OpenAirCgn/quadsense/README.md

# OpenAir Quadsense Module

This is an extension module for the OpenAir.cgn base board
to connect to Alphasense gas concentration sensors using
Alphasense ISB boards to provide amplifier circuitry.

Schematics
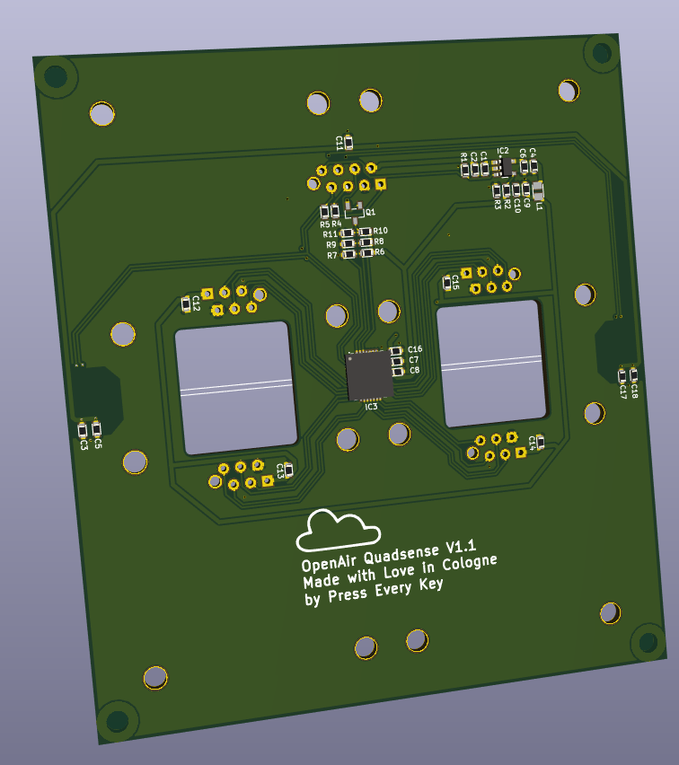
[picture p1: quadsense-classic.png]
Board
