OpenAirCgn/quadsense/Quadsense_BOM.ods

 |  |  |  |  |  |  |  |  |  |  |  | Units:
Non-listed components are unpopulated |  |  |  |  |  |  |  |  |  |  |  | 7
Qty | Reference(s) | Value | Footprint | Manufacturer | PN | Source | Source # | Source € | Source @ | Remarks | Cost/part | Needed | Avail | Remaining | Cost needed | Order | Cost order
 | Resistors
2 | R1, R10 | 10K | 0603 |  |  | avail |  |  |  |  | 0 | 14 | 999 | 0 | 0 |  | 0
1 | R2 | 9K1 | 0603 | Susumu | RR0816P-912-D | DK | RR08P9.1KDCT-ND | 0,086 | 10 |  | 0,086 | 7 | 7 | 0 | 0,602 | 10 | 0,86
1 | R3 | 2K2 | 0603 |  |  | avail |  |  |  |  | 0 | 7 | 999 | 0 | 0 |  | 0
5 | R6, R7, R8, R9, R11 | 0/DNP | 0603 |  |  | avail |  |  |  |  | 0 | 35 | 999 | 0 | 0 |  | 0
 |  |  |  |  |  |  |  |  |  |  |  |  |  |  |  |  | 0
 | Capacitors |  |  |  |  |  |  |  |  |  |  |  |  |  |  |  | 0
6 | C1, C2, C4, C6, C9, C11 | 1u | 0603 |  |  | avail |  |  |  |  | 0 | 42 | 999 | 0 | 0 |  | 0
9 | C3, C5, C7, C12, C13, C14, C15, C17, C18 | 0.1u | 0603 |  |  | avail |  |  |  |  | 0 | 63 | 999 | 0 | 0 |  | 0
2 | C8, C10 | 10u | 0603 | AVX | 0603ZD106KAT2A | DK | 478-10766-1-ND | 0,104 | 10 |  | 0,208 | 14 | 16 | 0 | 1,456 | 25 | 2,6 | incl noiseboard
1 | C16 | 1u/DNP
 |  |  |  |  |  |  |  |  |  |  |  |  |  |  |  |  | 0
 | Inductors |  |  |  |  |  |  |  |  |  |  |  |  |  |  |  | 0
1 | L1 | 22uH 1.27Ω | 0805 | TDK | MLZ2012P220WT000 | DK | 445-15751-1-ND | 0,115 | 10 |  | 0,115 | 7 |  | 7 | 0,805 | 10 | 1,15
1 | L1 | 47uH 3.7Ω | 0805 | TDK | MLZ2012M470WT000 | DK | 445-6400-1-ND | 0,115 | 10 |  | 0,115 | 7 |  | 7 | 0,805 | 10 | 1,15 | second option
 |  |  |  |  |  |  |  |  |  |  |  |  |  |  |  |  | 0
 | Discrete semiconductors |  |  |  |  |  |  |  |  |  |  |  |  |  |  |  | 0
1 | Q1 | AO3418 | SOT23-3 | A&O |  | DK | 785-1012-1-ND | 0,272 | 10 |  | 0,272 | 7 | 5 | 2 | 1,904 | 5 | 1,36
 |  |  |  |  |  |  |  |  |  |  |  |  |  |  |  |  | 0
 | ICs |  |  |  |  |  |  |  |  |  |  |  |  |  |  |  | 0
2 | IC1, IC4 | RH/T sens BME280 | BME280 | Bosch | BME280 | DK | 828-1063-1-ND | 6,86 | 1 |  | 13,72 | 14 | 4 | 10 | 96,04 | 10 | 68,6
1 | IC2 | LDO AP7330 | SOT23-5 | Diodes Inc | AP7330-W5-7 | DK | AP7330-W5-7DICT-ND | 0,315 | 10 |  | 0,315 | 7 | 3 | 4 | 2,205 | 4 | 1,26
1 | IC3 | ADC LTC2497 | QFN-38-12-7-0.5-EP | Linear Tech | LTC2497CUHF#PBF | DK | LTC2497CUHF#PBF-ND | 4,86 | 1 |  | 4,86 | 7 | 3 | 4 | 34,02 | 4 | 19,44
 |  |  |  |  |  |  |  |  |  |  |  |  |  |  |  |  | 0
 | Mechanical |  |  |  |  |  |  |  |  |  |  |  |  |  |  |  | 0
4 | P1, P2, P3, P4 | WTB direct conn 6 pin | HEADER-1x06-1.27-ZZ-POL | TE | 215570-6 | DK | A111110CT-ND | 0,54 | 10 |  | 2,16 | 28 | 20 | 8 | 15,12 | 10 | 5,4
1 | P5 | WTB direct conn 8 pin | HEADER-1x08-1.27-ZZ-POL | TE | 215570-8 | DK | A111111CT-ND | 0,56 | 10 |  | 0,56 | 7 | 10 | 0 | 3,92 | 15 | 8,4 | incl noiseboard
1 |  | WTB plug 8 pin |  | TE | 2178712-8 | DK | A120922CT-ND | 0,465 | 10 |  | 0,465 | 7 | 3 | 4 | 3,255 | 20 | 9,3 | incl noiseboard
4 |  | Sensor plug housing pol |  | Molex | 0022013067 | DK | WM2004-ND | 0,23 | 1 |  | 0,92 | 28 | 17 | 11 | 6,44 | 12 | 2,76
4 |  | Sensor plug housing |  | Molex | 0022012067 | DK | WM2015-ND | 0,23 | 1 |  | 0,92 | 28 |  | 28 | 6,44 |  | 0 | not needed
24 |  | Sensor plug contact |  | Molex | 0008500113 | DK | WM1114CT-ND | 0,037 | 100 |  | 0,888 | 168 | 100 | 68 | 6,216 | 200 | 7,4 | Incl Openair PM
16 |  | Spacer M3 3-5mm |  | Bivar | 9911-125 | DK | 492-1087-ND | 0,0296 | 100 |  | 0,4736 | 112 | 112 | 0 | 3,3152 |  | 0 | reichelt if needed
32 |  | Screw / nut M3
 | Ribbon cable (various) |  |  |  |  |  |  |  |  |  | 26,0776 |  |  |  | 182,5432 |  | 129,68
 | Foam 5mm
 | Thread glue
 |  |  |  |  |  |  |  |  |  |  |  |  |  |  |  | TODO: Vibrationsmotoren
 |  |  |  |  |  |  |  |  |  |  |  |  |  |  |  | TODO: Stecker / Buchsen SDS011
