OpenAirCgn/quadsense/(commit log)

2019-03-18 Initial version
    [Quadsense BOM.ods, Quadsense.kicad_pcb, Quadsense.sch]
2019-03-20 Copper pour inset, added Gerber files
    [Quadsense-B.Cu.gbr, Quadsense-B.Mask.gbr, Quadsense-B.SilkS.gbr, Quadsense-Edge.Cuts.gbr, Quadsense-F.Cu.gbr, Quadsense-F.Mask.gbr, Quadsense-F.SilkS.gbr, Quadsense-NPTH.drl]
2019-06-04 Added second BME280, fixed footprints, better analog decoupling, resized module board
    [Quadsense.kicad_pcb, Quadsense.sch]
2019-06-04 Saved files
    [Quadsense.kicad_pcb, Quadsense.sch]
2019-06-06 Silkscreen fixes
    [Quadsense-B.Cu.gbr, Quadsense-B.Mask.gbr, Quadsense-B.SilkS.gbr, Quadsense-Edge.Cuts.gbr, Quadsense-F.Cu.gbr, Quadsense-F.Mask.gbr, Quadsense-F.SilkS.gbr, Quadsense-NPTH.drl]
2019-06-06 Saved changes
    [Quadsense.sch]
2019-08-29 BOM changes, BOM rename
    [Quadsense BOM.ods, Quadsense_BOM.ods]
2019-08-29 alphasense docs
    [sensitivity.csv]
